banczok/amp_class_d/amp_ctrl/amp_ctrl.kicad_pcb

## KiCad design amp_ctrl/amp_ctrl.kicad_pcb (2026-09-16)

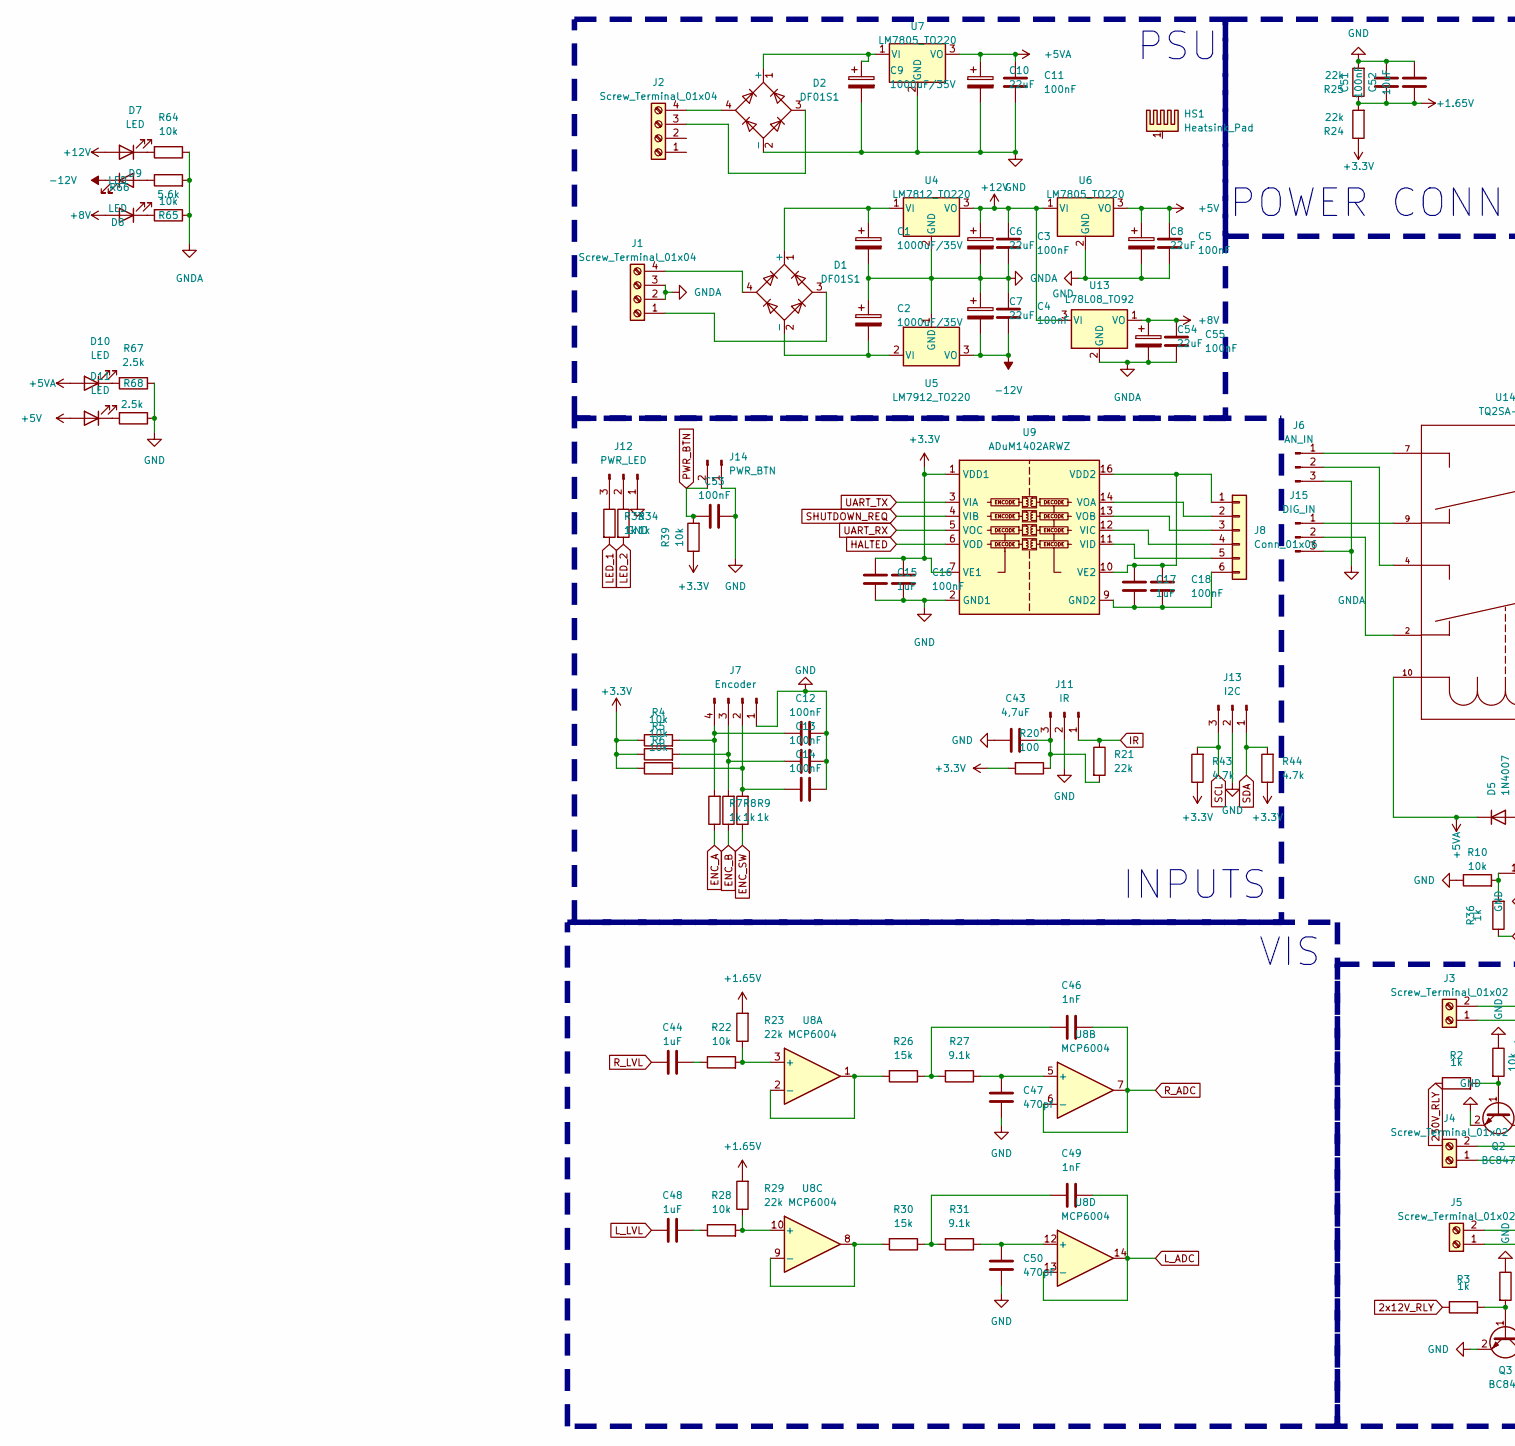
[picture p1: schematic amp_ctrl.kicad_sch, part in row 1, column 1]

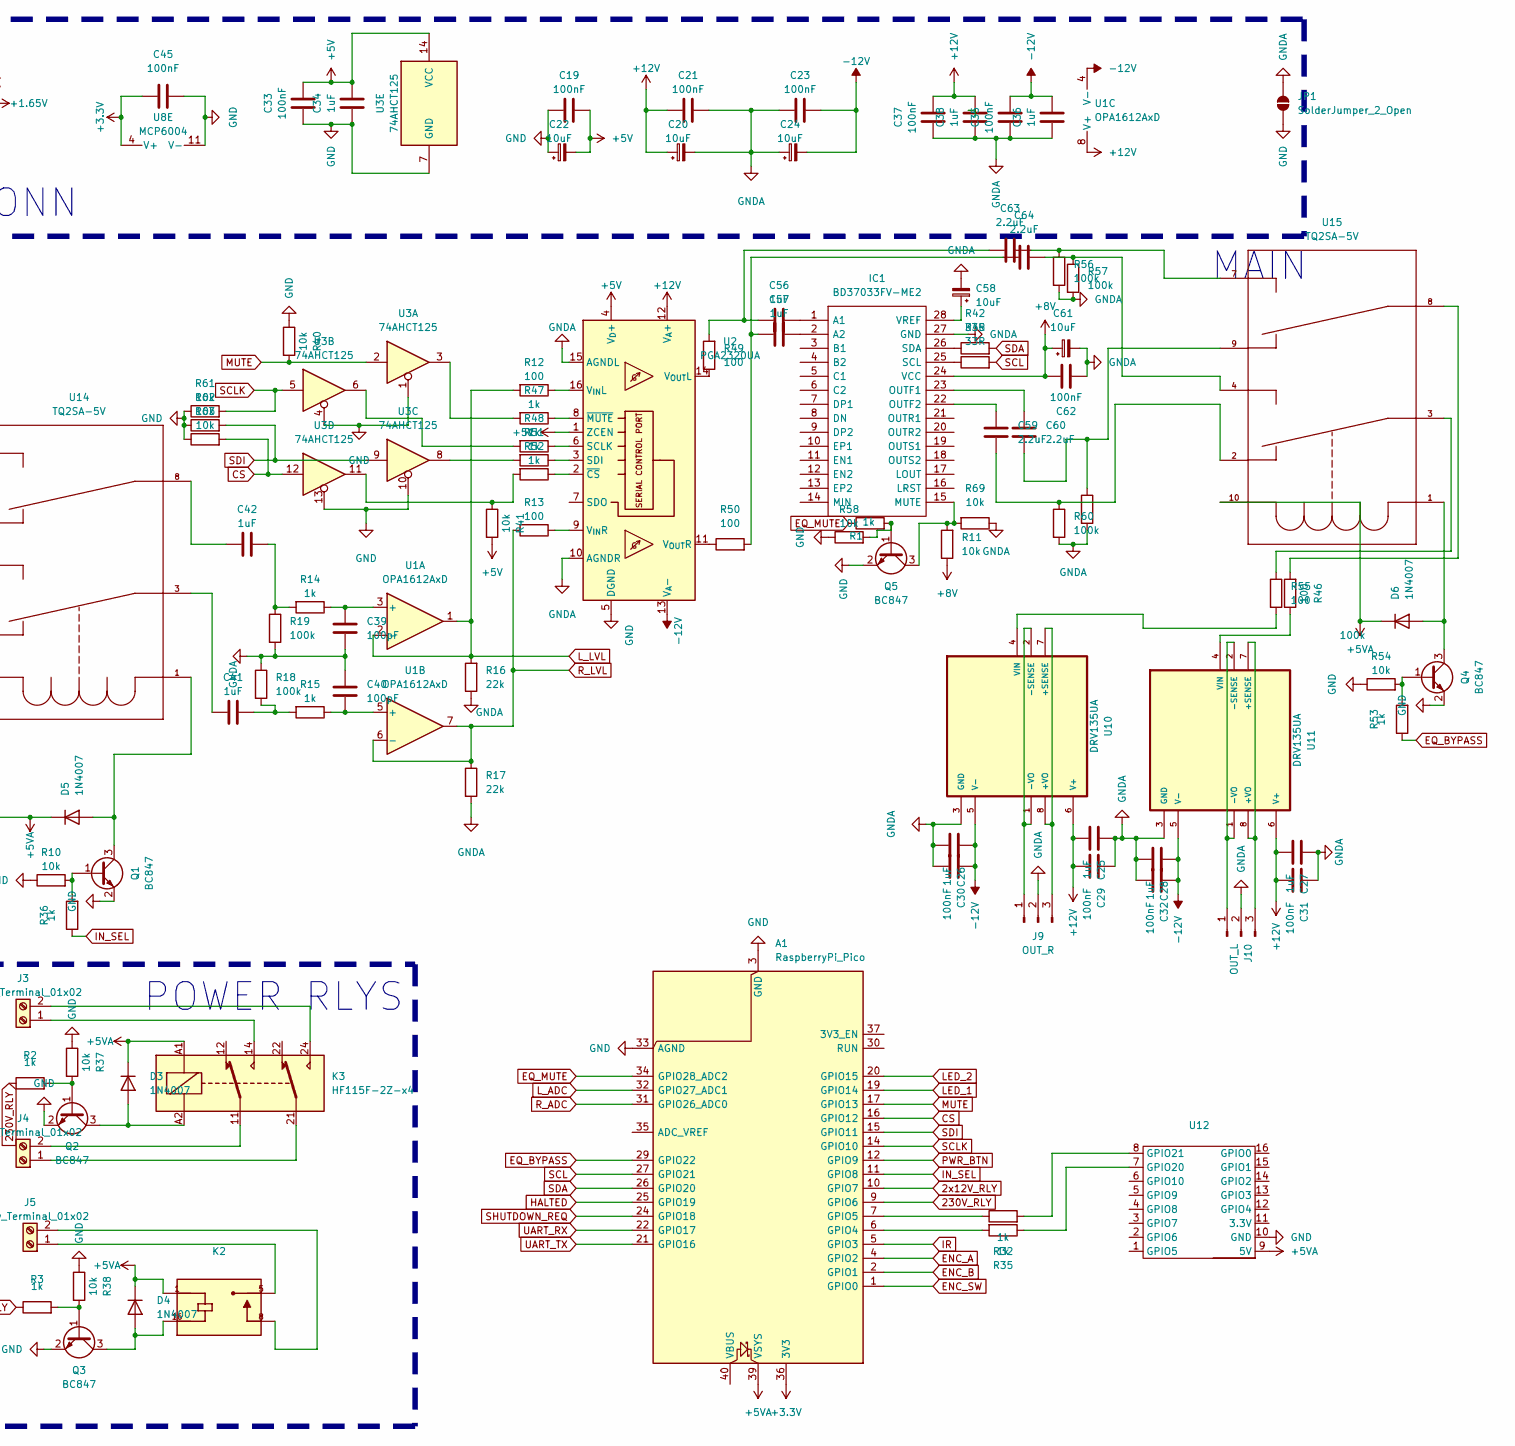
[picture p2: schematic amp_ctrl.kicad_sch, part in row 1, column 2]

Parts:
A1: RaspberryPi_Pico; RaspberryPi_Pico_Common_SMD
C1, C2, C9: 1000uF/35V; CP_Radial_D12.5mm_P5.00mm
C3, C4, C5, C11, C12, C13, C14, C16, C18, C19, C21, C23, C29, C30, C31, C32, C33, C35, C37, C45, C51, C53, C55, C62: 100nF; C_0805_2012Metric_Pad1.18x1.45mm_HandSolder
C6, C7, C8, C10, C54: 22uF; CP_Radial_D5.0mm_P2.50mm
C15, C17, C25, C26, C27, C28, C34, C36, C38: 1uF; C_0805_2012Metric_Pad1.18x1.45mm_HandSolder
C20, C22, C24, C58, C61: 10uF; CP_EIA-6032-28_Kemet-C_Pad2.25x2.35mm_HandSolder
C39, C40: 100pF; C_0805_2012Metric_Pad1.18x1.45mm_HandSolder
C41, C42, C44, C48, C56, C57: 1uF; C_Disc_D8.0mm_W5.0mm_P5.00mm
C43: 4,7uF; C_0805_2012Metric_Pad1.18x1.45mm_HandSolder
C46, C49: 1nF; C_0805_2012Metric_Pad1.18x1.45mm_HandSolder
C47: 470pf; C_0805_2012Metric_Pad1.18x1.45mm_HandSolder
C50: 470pF; C_0805_2012Metric_Pad1.18x1.45mm_HandSolder
C52: 10uF; C_0805_2012Metric_Pad1.18x1.45mm_HandSolder
C59, C60, C63, C64: 2.2uF; C_Disc_D8.0mm_W5.0mm_P5.00mm
D1, D2: DF01S1; Diode_Bridge_OnSemi_SDIP-4L
D3, D4, D5, D6: 1N4007; D_DO-41_SOD81_P10.16mm_Horizontal
D7, D8, D9, D10, D11: LED; LED_1206_3216Metric_Pad1.42x1.75mm_HandSolder
HS1: Heatsink_Pad; Heatsink_Fischer_SK104-STC-STIC_35x13mm_2xDrill2.5mm
IC1: BD37033FV-ME2; SSOP-28_5.3x10.2mm_P0.65mm; Mouser Part Number 755-BD37033FV-ME2
J1, J2: Screw_Terminal_01x04; TerminalBlock_Phoenix_MKDS-1,5-4_1x04_P5.00mm_Horizontal
J3, J4, J5: Screw_Terminal_01x02; TerminalBlock_MaiXu_MX126-5.0-02P_1x02_P5.00mm
J6: AN_IN; PinHeader_1x03_P2.54mm_Vertical
J7: Encoder; PinHeader_1x04_P2.54mm_Vertical
J8: Conn_01x06; PinHeader_1x06_P2.54mm_Vertical
J9: OUT_R; PinHeader_1x03_P2.54mm_Vertical
J10: OUT_L; PinHeader_1x03_P2.54mm_Vertical
J11: IR; PinHeader_1x03_P2.54mm_Vertical
J12: PWR_LED; PinHeader_1x03_P2.54mm_Vertical
J13: I2C; PinHeader_1x03_P2.54mm_Vertical
J14: PWR_BTN; PinSocket_1x02_P2.54mm_Vertical
J15: DIG_IN; PinHeader_1x03_P2.54mm_Vertical
JP1: SolderJumper_2_Open; SolderJumper-2_P1.3mm_Open_Pad1.0x1.5mm
K2: PR30-12V-450-1A; RELAY_PR30-12V-450-1A; PARTREV 1.0
K3: HF115F-2Z-x4; Relay_DPDT_Finder_40.62
Q1, Q2, Q3, Q4, Q5: BC847; SOT-23
R1, R2, R3, R7, R8, R9, R14, R15, R32, R33, R34, R35, R36, R47, R48, R51, R52, R53: 1k; R_0805_2012Metric_Pad1.20x1.40mm_HandSolder
R4, R5, R6, R10, R11, R22, R28, R37, R38, R39, R40, R41, R54, R58, R61, R62, R63, R64, R65, R69: 10k; R_0805_2012Metric_Pad1.20x1.40mm_HandSolder
R12, R13, R20, R46, R49, R50, R55: 100; R_0805_2012Metric_Pad1.20x1.40mm_HandSolder
R16, R17, R21, R23, R24, R25, R29: 22k; R_0805_2012Metric_Pad1.20x1.40mm_HandSolder
R18, R19, R56, R57, R59, R60: 100k; R_0805_2012Metric_Pad1.20x1.40mm_HandSolder
R26, R30: 15k; R_0805_2012Metric_Pad1.20x1.40mm_HandSolder
R27, R31: 9.1k; R_0805_2012Metric_Pad1.20x1.40mm_HandSolder
R42, R45: 33R; R_0805_2012Metric_Pad1.20x1.40mm_HandSolder
R43, R44: 4.7k; R_0805_2012Metric_Pad1.20x1.40mm_HandSolder
R66: 5.6k; R_0805_2012Metric_Pad1.20x1.40mm_HandSolder
R67, R68: 2.5k; R_0805_2012Metric_Pad1.20x1.40mm_HandSolder
U1: OPA1612AxD; SOIC-8_3.9x4.9mm_P1.27mm
U2: PGA2320UA; SOIC-16W_7.5x10.3mm_P1.27mm
U3: 74AHCT125; SOIC-14_3.9x8.7mm_P1.27mm
U4: LM7812_TO220; TO-220-3_Vertical
U5: LM7912_TO220; TO-220-3_Vertical
U6, U7: LM7805_TO220; TO-220-3_Vertical
U8: MCP6004; SOIC-14_3.9x8.7mm_P1.27mm
U9: ADuM1402ARWZ; SOIC-16W_7.5x10.3mm_P1.27mm
U10, U11: DRV135UA; SOIC-8_3.9x4.9mm_P1.27mm
U12: ESP_C3_SUPERMINI_MINE_SMD
U13: L78L08_TO92; TO-92_Inline
U14, U15: TQ2SA-5V; RELAY_TQ2_SA_PAN

Connections:
2x12V_RLY: A1.10 (GPIO7), R3.1
230V_RLY: A1.9 (GPIO6), R2.1
+1.65V: C51.1, C52.1, R23.2, R24.2, R25.1, R29.2
+3.3V: A1.36 (3V3), C15.1, C16.1, C45.1, R4.1, R5.1, R6.1, R20.2, R24.1, R39.1, R43.1, R44.1, U8.4 (V+), U9.1 (VDD1), U9.7 (VE1)
+5V: C5.1, C8.1, C19.1, C22.2, C33.1, C34.2, D11.2 (A), R41.2, U2.1 (ZCEN), U2.4 (V_{D}+), U3.14 (VCC), U6.3 (VO)
+5VA: A1.39 (VSYS), C10.1, C11.1, D3.1 (K), D4.1 (K), D5.1 (K), D6.1 (K), D10.2 (A), K2.1, K3.A1, U7.3 (VO), U12.9 (5V), U14.10, U15.10
+8V: C54.1, C55.1, C61.1, C62.1, D9.2 (A), IC1.24 (VCC), R11.1, U13.1 (VO)
+12V: C3.1, C6.1, C20.1, C21.2, C25.2, C27.2, C29.2, C31.2, C37.1, C38.2, D7.2 (A), U1.8 (V+), U2.12 (V_{A}+), U4.3 (VO), U6.1 (VI), U10.6 (V+), U11.6 (V+), U13.3 (VI)
-12V: C4.2, C7.2, C23.1, C24.2, C26.1, C28.1, C30.1, C32.1, C35.1, C36.2, D8.1 (K), U1.4 (V-), U2.13 (V_{A}-), U5.3 (VO), U10.5 (V-), U11.5 (V-)
CS: A1.16 (GPIO12), R63.2, U3.12
ENC_A: A1.4 (GPIO2), R7.1
ENC_B: A1.2 (GPIO1), R8.1
ENC_SW: A1.1 (GPIO0), R9.1
EQ_BYPASS: A1.29 (GPIO22), R53.1
EQ_MUTE: A1.34 (GPIO28_ADC2), R1.1
GND: A1.3 (GND), A1.8 (GND), A1.13 (GND), A1.18 (GND), A1.23 (GND), A1.28 (GND), A1.33 (AGND), A1.38 (GND), C5.2, C8.2, C9.2, C10.2, C11.2, C12.2, C13.2, C14.2, C15.2, C16.2, C19.2, C22.1, C33.2, C34.1, C43.2, C45.2, C47.2, C50.2, C51.2, C52.2, C53.2, D2.2 (-), J7.1, J11.2, J12.1, J13.2, J14.1, JP1.1 (A), Q1.2 (E), Q2.2 (E), Q3.2 (E), Q4.2 (E), Q5.2 (E), R10.1, R25.2, R37.1, R38.1, R40.1, R54.1, R58.1, R61.1, R62.1, R63.1, R67.1, R68.1, U2.5 (DGND), U3.1, U3.4, U3.7 (GND), U3.10, U3.13, U6.2 (GND), U7.2 (GND), U8.11 (V-), U9.2 (GND1), U9.8 (GND1), U12.10 (GND); also elsewhere on the board
GNDA: C1.2, C2.1, C3.2, C4.1, C6.2, C7.1, C20.2, C21.1, C23.2, C24.1, C25.1, C26.2, C27.1, C28.2, C29.1, C30.2, C31.1, C32.2, C35.2, C36.1, C37.2, C38.1, C39.2, C40.1, C54.2, C55.2, C58.2, C61.2, C62.2, IC1.27 (GND), J1.2, J1.3, J6.3, J9.2, J10.2, J15.3, JP1.2 (B), R16.1, R17.2, R18.1, R19.2, R56.2, R57.2, R59.2, R60.2, R64.1, R65.2, R66.1, R69.1, U2.10 (AGNDR), U2.15 (AGNDL), U4.2 (GND), U5.1 (GND), U10.3 (GND), U11.3 (GND), U13.2 (GND); also elsewhere on the board
HALTED: A1.25 (GPIO19), U9.6 (VOD)
IN_SEL: A1.11 (GPIO8), R36.1
IR: A1.5 (GPIO3), J11.1, R21.1; also elsewhere on the board
LED_1: A1.19 (GPIO14), R33.2
LED_2: A1.20 (GPIO15), R34.2
L_ADC: A1.32 (GPIO27_ADC1), C49.1, U8.13 (-), U8.14
L_LVL: C48.1, R12.2, R16.2, U1.1, U1.2 (-)
MUTE: A1.17 (GPIO13), R40.2, U3.2
unnamed: A1.6 (GPIO4), R35.2
unnamed: A1.7 (GPIO5), R32.1
unnamed: C41.1, U14.3
unnamed: C41.2, R15.2, R18.2
unnamed: C42.1, U14.8
unnamed: C42.2, R14.2, R19.1
unnamed: C44.2, R22.1
unnamed: C46.2, R26.1, R27.2
unnamed: C48.2, R28.1
unnamed: C49.2, R30.1, R31.2
unnamed: C56.1, C63.2, R49.2
unnamed: C57.1, C64.2, R50.2
unnamed: C59.1, R60.1, U15.2
unnamed: C60.1, R59.1, U15.9
unnamed: C63.1, R56.1, U15.7
unnamed: C64.1, R57.1, U15.4
unnamed: C1.1, D1.1 (+), U4.1 (VI)
unnamed: C2.2, D1.2 (-), U5.2 (VI)
unnamed: C9.1, D2.1 (+), U7.1 (VI)
unnamed: D3.2 (A), K3.A2, Q2.3 (C)
unnamed: D4.2 (A), K2.16, Q3.3 (C)
unnamed: D5.2 (A), Q1.3 (C), U14.1
unnamed: D6.2 (A), Q4.3 (C), U15.1
unnamed: D7.1 (K), R64.2
unnamed: D8.2 (A), R65.1
unnamed: D9.1 (K), R66.2
unnamed: D10.1 (K), R67.2
unnamed: D11.1 (K), R68.2
unnamed: C56.2, IC1.1 (A1)
unnamed: C57.2, IC1.2 (A2)
unnamed: IC1.15 (MUTE), Q5.3 (C), R11.2, R69.2
unnamed: C60.2, IC1.23 (OUTF1)
unnamed: C59.2, IC1.22 (OUTF2)
unnamed: IC1.25 (SCL), R45.1
unnamed: IC1.26 (SDA), R42.1
unnamed: C58.1, IC1.28 (VREF)
unnamed 61: D1.3, J1.1; also elsewhere on the board
unnamed 62: D1.4, J1.4; also elsewhere on the board
unnamed 63: D2.3, J2.3; also elsewhere on the board
unnamed 64: D2.4, J2.4; also elsewhere on the board
unnamed 65: J3.1, K3.14; also elsewhere on the board
unnamed 66: J3.2, K3.24; also elsewhere on the board
unnamed 67: J4.1, K3.21; also elsewhere on the board
unnamed 68: J4.2, K3.11; also elsewhere on the board
unnamed 69: J5.1, K2.5; also elsewhere on the board
unnamed 70: J5.2, K2.8; also elsewhere on the board
unnamed 71: J6.1, U14.7; also elsewhere on the board
unnamed 72: J6.2, U14.4; also elsewhere on the board
unnamed 73: C14.1, J7.2, R6.2, R9.2; also elsewhere on the board
unnamed 74: C13.1, J7.3, R5.2, R8.2; also elsewhere on the board
unnamed 75: C12.1, J7.4, R4.2, R7.2; also elsewhere on the board
unnamed 76: C17.1, C18.1, J8.1, U9.10 (VE2), U9.16 (VDD2); also elsewhere on the board
unnamed 77: J8.2, U9.14 (VOA); also elsewhere on the board
unnamed 78: J8.3, U9.13 (VOB); also elsewhere on the board
unnamed 79: J8.4, U9.12 (VIC); also elsewhere on the board
unnamed 80: J8.5, U9.11 (VID); also elsewhere on the board
unnamed 81: C17.2, C18.2, J8.6, U9.9 (GND2), U9.15 (GND2); also elsewhere on the board
unnamed 82: J9.1, U10.1 (-VO), U10.2 (-SENSE); also elsewhere on the board
unnamed 83: J9.3, U10.7 (+SENSE), U10.8 (+VO); also elsewhere on the board
unnamed 84: J10.1, U11.1 (-VO), U11.2 (-SENSE); also elsewhere on the board
unnamed 85: J10.3, U11.7 (+SENSE), U11.8 (+VO); also elsewhere on the board
unnamed 86: C43.1, J11.3, R20.1, R21.2; also elsewhere on the board
unnamed 87: J12.2, R34.1; also elsewhere on the board
unnamed 88: J12.3, R33.1; also elsewhere on the board
unnamed 89: J15.1, U14.9; also elsewhere on the board
unnamed 90: J15.2, U14.2; also elsewhere on the board
unnamed: Q1.1 (B), R10.2, R36.2
unnamed: Q2.1 (B), R2.2, R37.2
unnamed: Q3.1 (B), R3.2, R38.2
unnamed: Q4.1 (B), R53.2, R54.2
unnamed: Q5.1 (B), R1.2, R58.2
unnamed: R41.1, R52.2, U3.11
unnamed: R46.2, U15.8
unnamed: R47.2, U3.3
unnamed: R48.2, U3.6
unnamed: R51.2, U3.8
unnamed: R55.1, U15.3
unnamed: C39.1, R14.1, U1.3 (+)
unnamed: C40.2, R15.1, U1.5 (+)
unnamed: R48.1, U2.6 (SCLK)
unnamed: R51.1, U2.3 (SDI)
unnamed: R12.1, U2.16 (V_{IN}L)
unnamed: R13.1, U2.9 (V_{IN}R)
unnamed: R49.1, U2.14 (V_{OUT}L)
unnamed: R50.1, U2.11 (V_{OUT}R)
unnamed: R52.1, U2.2 (~CS)
unnamed: R47.1, U2.8 (~MUTE)
unnamed: R22.2, R23.1, U8.3 (+)
unnamed: R26.2, U8.1, U8.2 (-)
unnamed: C47.1, R27.1, U8.5 (+)
unnamed: R28.2, R29.1, U8.10 (+)
unnamed: R30.2, U8.8, U8.9 (-)
unnamed: C50.1, R31.1, U8.12 (+)
unnamed: R55.2, U10.4 (VIN)
unnamed: R46.1, U11.4 (VIN)
unnamed: R35.1, U12.7 (GPIO20)
unnamed: R32.2, U12.8 (GPIO21)
PWR_BTN: A1.12 (GPIO9), C53.1, J14.2, R39.2; also elsewhere on the board
R_ADC: A1.31 (GPIO26_ADC0), C46.1, U8.6 (-), U8.7
R_LVL: C44.1, R13.2, R17.1, U1.6 (-), U1.7
SCL: A1.27 (GPIO21), J13.3, R43.2, R45.2; also elsewhere on the board
SCLK: A1.14 (GPIO10), R61.2, U3.5
SDA: A1.26 (GPIO20), J13.1, R42.2, R44.2; also elsewhere on the board
SDI: A1.15 (GPIO11), R62.2, U3.9
SHUTDOWN_REQ: A1.24 (GPIO18), U9.4 (VIB)
UART_RX: A1.22 (GPIO17), U9.5 (VOC)
UART_TX: A1.21 (GPIO16), U9.3 (VIA)

Notes on the sheet:
VIS
PSU
POWER CONN
MAIN
POWER RLYS
INPUTS

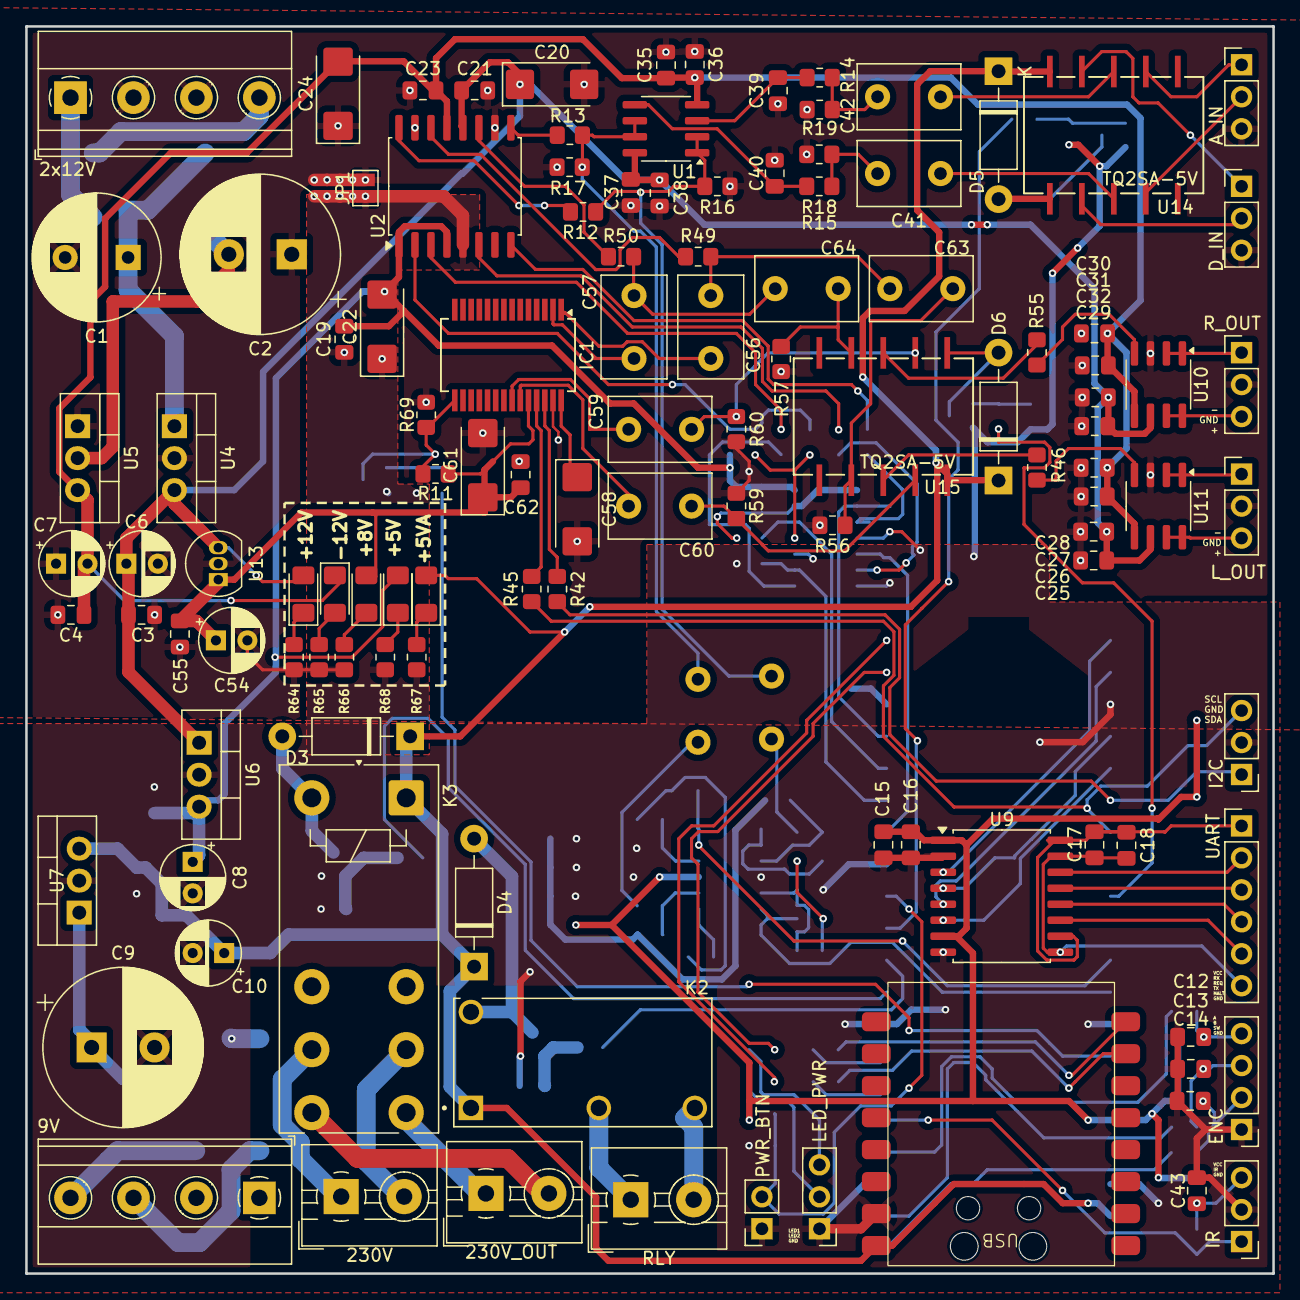
[picture p3: board amp_ctrl.kicad_pcb from above]

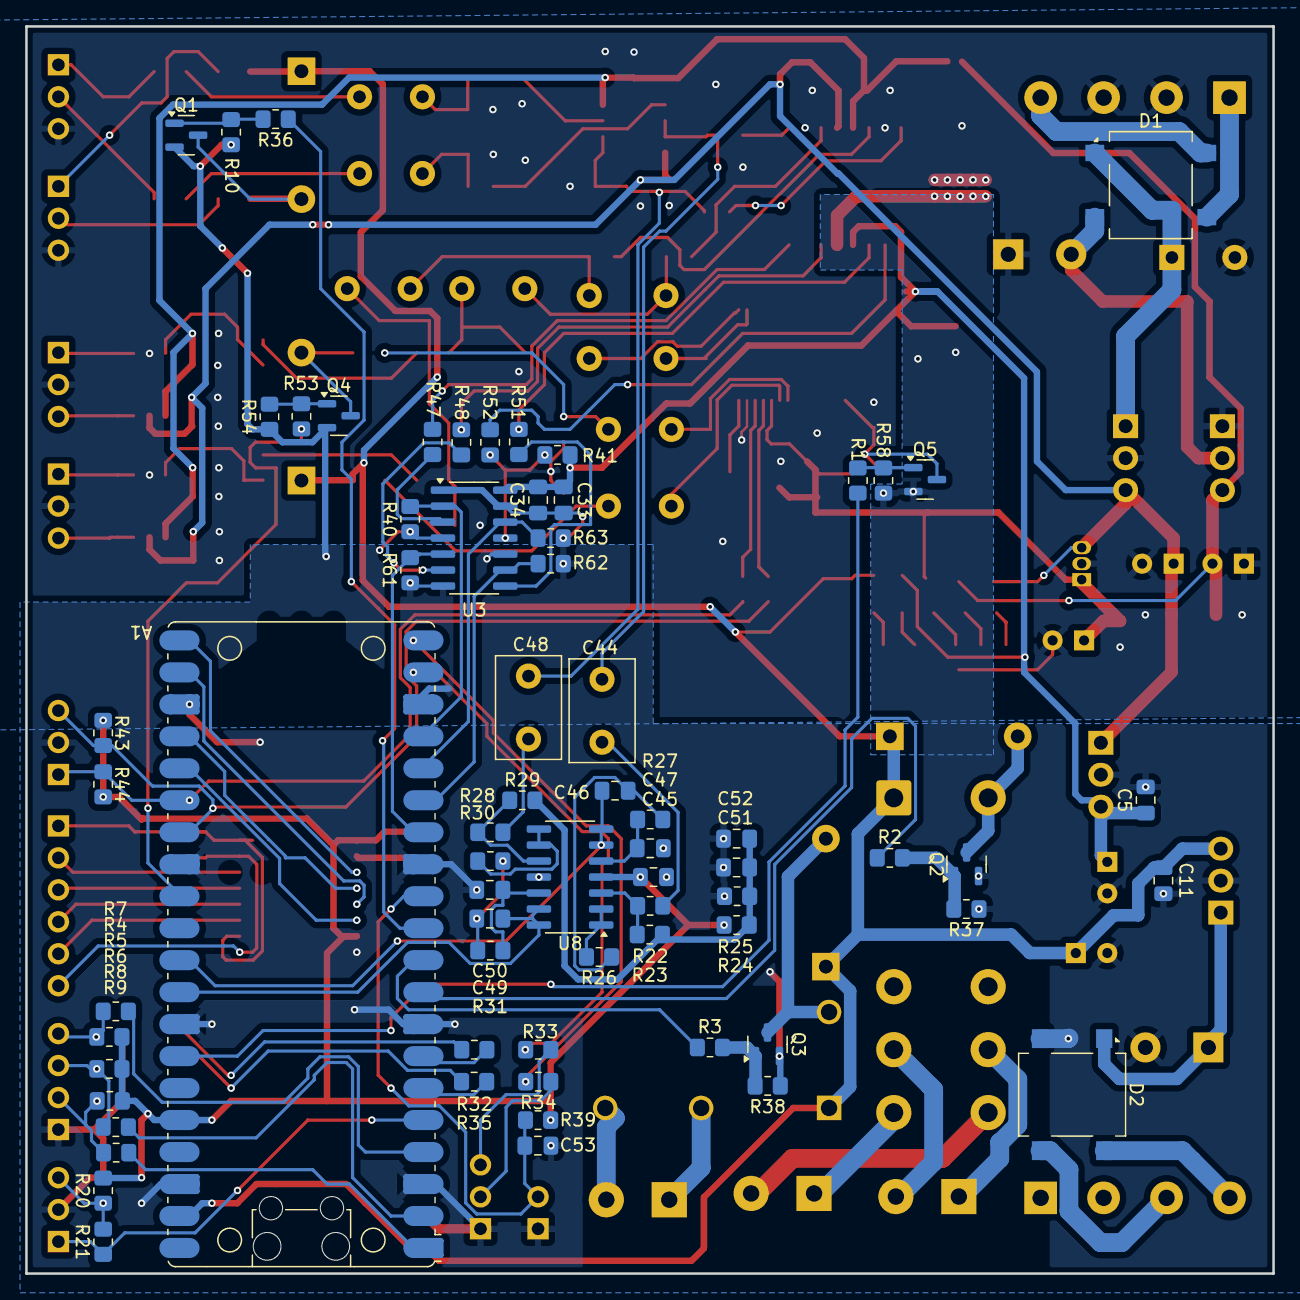
[picture p4: board amp_ctrl.kicad_pcb from below]

Board: 4 copper layers, 99.1 x 99.1 mm, 184 parts (68 on the bottom side), 132 nets.

Other parts of the board:
2x12V, 9V: Screw_Terminal_01x04; TerminalBlock_Phoenix_MKDS-1,5-4_1x04_P5.00mm_Horizontal
230V, 230V_OUT: Screw_Terminal_01x02; TerminalBlock_MaiXu_MX126-5.0-02P_1x02_P5.00mm
A_IN: AN_IN; PinHeader_1x03_P2.54mm_Vertical
D_IN: DIG_IN; PinHeader_1x03_P2.54mm_Vertical
ENC: Encoder; PinHeader_1x04_P2.54mm_Vertical
I2C: I2C; PinHeader_1x03_P2.54mm_Vertical
IR: IR; PinHeader_1x03_P2.54mm_Vertical
LED_PWR: PWR_LED; PinHeader_1x03_P2.54mm_Vertical
L_OUT: OUT_L; PinHeader_1x03_P2.54mm_Vertical
PWR_BTN: PWR_BTN; PinSocket_1x02_P2.54mm_Vertical
RLY: Screw_Terminal_01x02; TerminalBlock_MaiXu_MX126-5.0-02P_1x02_P5.00mm
R_OUT: OUT_R; PinHeader_1x03_P2.54mm_Vertical
UART: Conn_01x06; PinHeader_1x06_P2.54mm_Vertical

Their connections:
GND: ENC.1, I2C.2, IR.2, LED_PWR.1, PWR_BTN.1; also elsewhere on the board
GNDA: 2x12V.2, 2x12V.3, A_IN.3, D_IN.3, L_OUT.2, R_OUT.2; also elsewhere on the board
IR: IR.1; also elsewhere on the board
unnamed 61: 2x12V.1; also elsewhere on the board
unnamed 62: 2x12V.4; also elsewhere on the board
unnamed 63: 9V.3; also elsewhere on the board
unnamed 64: 9V.4; also elsewhere on the board
unnamed 65: 230V_OUT.1; also elsewhere on the board
unnamed 66: 230V_OUT.2; also elsewhere on the board
unnamed 67: 230V.1; also elsewhere on the board
unnamed 68: 230V.2; also elsewhere on the board
unnamed 69: RLY.1; also elsewhere on the board
unnamed 70: RLY.2; also elsewhere on the board
unnamed 71: A_IN.1; also elsewhere on the board
unnamed 72: A_IN.2; also elsewhere on the board
unnamed 73: ENC.2; also elsewhere on the board
unnamed 74: ENC.3; also elsewhere on the board
unnamed 75: ENC.4; also elsewhere on the board
unnamed 76: UART.1; also elsewhere on the board
unnamed 77: UART.2; also elsewhere on the board
unnamed 78: UART.3; also elsewhere on the board
unnamed 79: UART.4; also elsewhere on the board
unnamed 80: UART.5; also elsewhere on the board
unnamed 81: UART.6; also elsewhere on the board
unnamed 82: R_OUT.1; also elsewhere on the board
unnamed 83: R_OUT.3; also elsewhere on the board
unnamed 84: L_OUT.1; also elsewhere on the board
unnamed 85: L_OUT.3; also elsewhere on the board
unnamed 86: IR.3; also elsewhere on the board
unnamed 87: LED_PWR.2; also elsewhere on the board
unnamed 88: LED_PWR.3; also elsewhere on the board
unnamed 89: D_IN.1; also elsewhere on the board
unnamed 90: D_IN.2; also elsewhere on the board
PWR_BTN: PWR_BTN.2; also elsewhere on the board
SCL: I2C.3; also elsewhere on the board
SDA: I2C.1; also elsewhere on the board
