banczok/amp_class_d/firmware/esp32c3/main/picolink.h

#ifndef PICOLINK_H
#define PICOLINK_H
#include <stdint.h>
#include <stdbool.h>

void picolink_init(void);                    /* starts the RX task      */
void picolink_send(uint8_t type, const uint8_t *p, uint8_t n);
bool picolink_pico_awake(void);              /* heard from it recently? */
#endif
