banczok/amp_class_d/(commit log)

2026-09-16 Preamp controller: board, three firmware trees, and the Pi service
    A DIY audio preamp controller built around four processors. The Pico is
    authoritative for volume, EQ, input and power; the Pi is a display and a
    touch surface, the ESP32-C3 a radio, the knob a remote. Pull the Pi cable
    and the encoder, the IR remote and the front-panel button still work.
    Nothing here has run on hardware yet. The three C trees compile clean
    under -Wall -Wextra against stub SDK headers, and the Python has five
    test suites that measure rather than assert.
    pico/ RP2350 controller: PGA2320, BD37033, relays, IR learning,
    settings menu, stereo metering on core 1, low-power standby
    esp32c3/ ESP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
    [ai_amp.kicad_pcb, amp_ctrl.csv, amp_ctrl.kicad_pcb, amp_ctrl.kicad_sch, partitions.csv]
2026-09-16 Drop the scratch board, add CLAUDE.md for sessions on any machine
    ai_amp.kicad_pcb was a placement copy edited as text, and it ended up
    internally inconsistent: footprint rotations were changed without the pad
    angles that must follow them, because KiCad stores a pad's angle
    absolutely rather than relative to its footprint. Twelve library parts
    had instances disagreeing on (pad angle - footprint rotation), a value
    that is necessarily constant per part in a KiCad-written file, and DRC
    read the result as about 93 shorts. amp_ctrl.kicad_pcb has none and is
    the only board from here on.
    CLAUDE.md is loaded automatically by Claude Code and imports CONTEXT.md,
    so a session started anywhere begins w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
    [ai_amp.kicad_pcb]
2026-09-16 Record what is built and what comes next, in enough detail to act on
    The status section was a four-row table, which is fine for a reminder and
    useless for resuming work weeks later on another machine. It now says
    what each module does, which tests exist and what each one measures, and
    what the next five pieces of work actually involve.
    The parts worth having written down rather than re-derived:
    - the REST and WebSocket surface, because the panel and the web UI are
    both clients of it and inventing two different contracts is the
    obvious way to lose a day
    - the visualiser module contract and the frame it is handed, since
    fifteen files have to agree on it
    - that band bytes ar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
